fassito/drone-2026/.github/skills/oled-display/references/ssd1306-vs-sh1106.md

# Referencia rápida: OLED SSD1306 vs SH1106

## Identificación

| Controlador | Tamaño | Resolución | Dirección I2C | Librería |
|---|---|---|---|---|
| **SSD1306** | 0.96" | 128×64 | `0x3C` (común) | Adafruit SSD1306 |
| **SH1106** | 1.3" | 128×64 | `0x3C` o `0x3D` | Adafruit SH110X / U8g2 |

Ambos usan 4 pines: **GND, VCC, SCL, SDA**.

## Cableado (ESP32)

| OLED | ESP32 |
|---|---|
| GND | GND |
| VCC | 3.3 V (o 5 V según módulo) |
| SCL | GPIO 22 |
| SDA | GPIO 21 |

## Escáner I2C (si no se conoce la dirección)

```cpp
#include <Wire.h>
void setup() {
  Wire.begin();
  Serial.begin(115200);
  for (uint8_t a = 1; a < 127; a++) {
    Wire.beginTransmission(a);
    if (Wire.endTransmission() == 0) {
      Serial.printf("I2C device en 0x%02X\n", a);
    }
  }
}
void loop() {}
```

## Librerías (platformio.ini)

- SSD1306:
  ```ini
  lib_deps =
      adafruit/Adafruit GFX Library @ ^1.11.9
      adafruit/Adafruit SSD1306 @ ^2.5.7
  ```
- SH1106 (con U8g2, soporta ambos chips):
  ```ini
  lib_deps =
      olikraus/U8g2 @ ^2.34.22
  ```

## Vistas propuestas

| Vista | Contenido |
|---|---|
| `status` | Armado, modo de vuelo, fallos |
| `attitude` | Roll, pitch, yaw |
| `gps` | Fix, satélites, lat/lon |
| `obstacle` | Distancias de los 4 Sharp |

## Notas

- Refrescar a 5–10 Hz desde una tarea RTOS separada (I2C es lento y bloqueante).
- La pantalla no debe ralentizar el bucle de control de 1 kHz.
