fassito/drone-2026/pcb/BOM.csv

Referencia | Componente | Pines | Nota
BEC1 | BEC 5V | 4
D1 | Flyback 1N4148 | 2
D2 | LED estado | 2
ESC1 | ESC 1 | 3
ESC2 | ESC 2 | 3
ESC3 | ESC 3 | 3
ESC4 | ESC 4 | 3
J1 | ESP32 DevKit V1 | 25
J2 | FS-IA6B iBus | 3
LS1 | Buzzer 5V | 2
Q1 | NPN 2N2222 | 3
R1 | Divisor 2.2k | 2
R2 | Divisor 4.7k | 2
R3 | Base 1k | 2
U10 | Sharp B | 3
U11 | Sharp L | 3
U2 | BMP388 CJMCU-388 | 6
U3 | INA219 | 6
U4 | OLED SSD1306 | 4
U5 | MPU-9250 GY-951 | 6
U6 | GPS Neo 6M | 4
U7 | HC-12 | 5
U8 | Sharp FR | 3
U9 | Sharp R | 3
XT1 | XT-60 batería | 2
