fassito/drone-2026/pcb/drone-2026.kicad_pcb

## KiCad design pcb/drone-2026.kicad_pcb (2026-11-11)

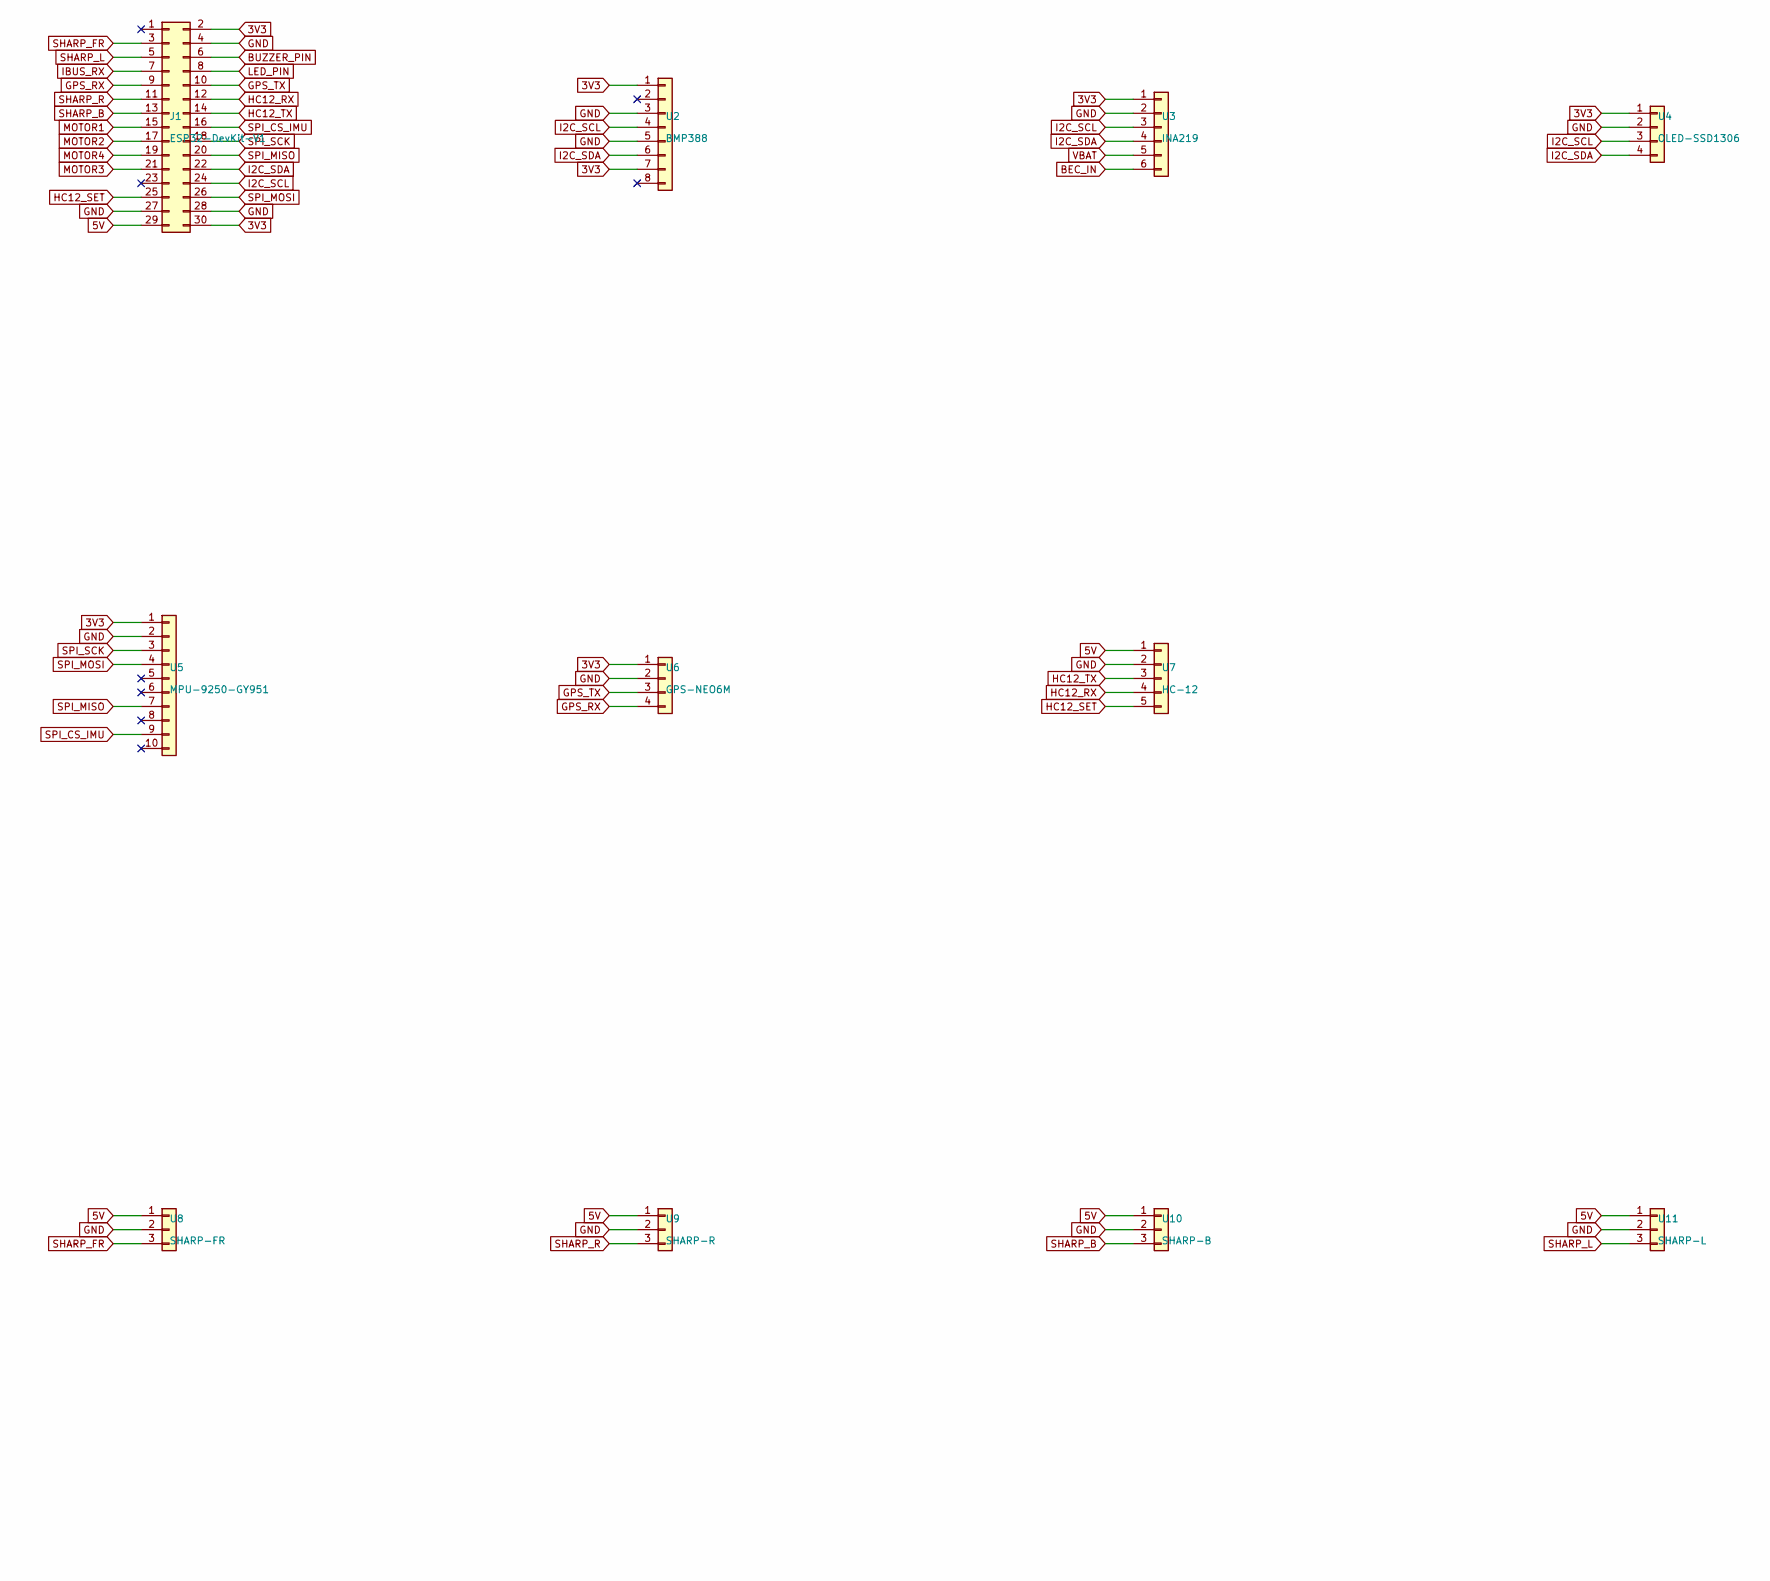
[picture p1: schematic drone-2026.kicad_sch, part in row 1, column 1]

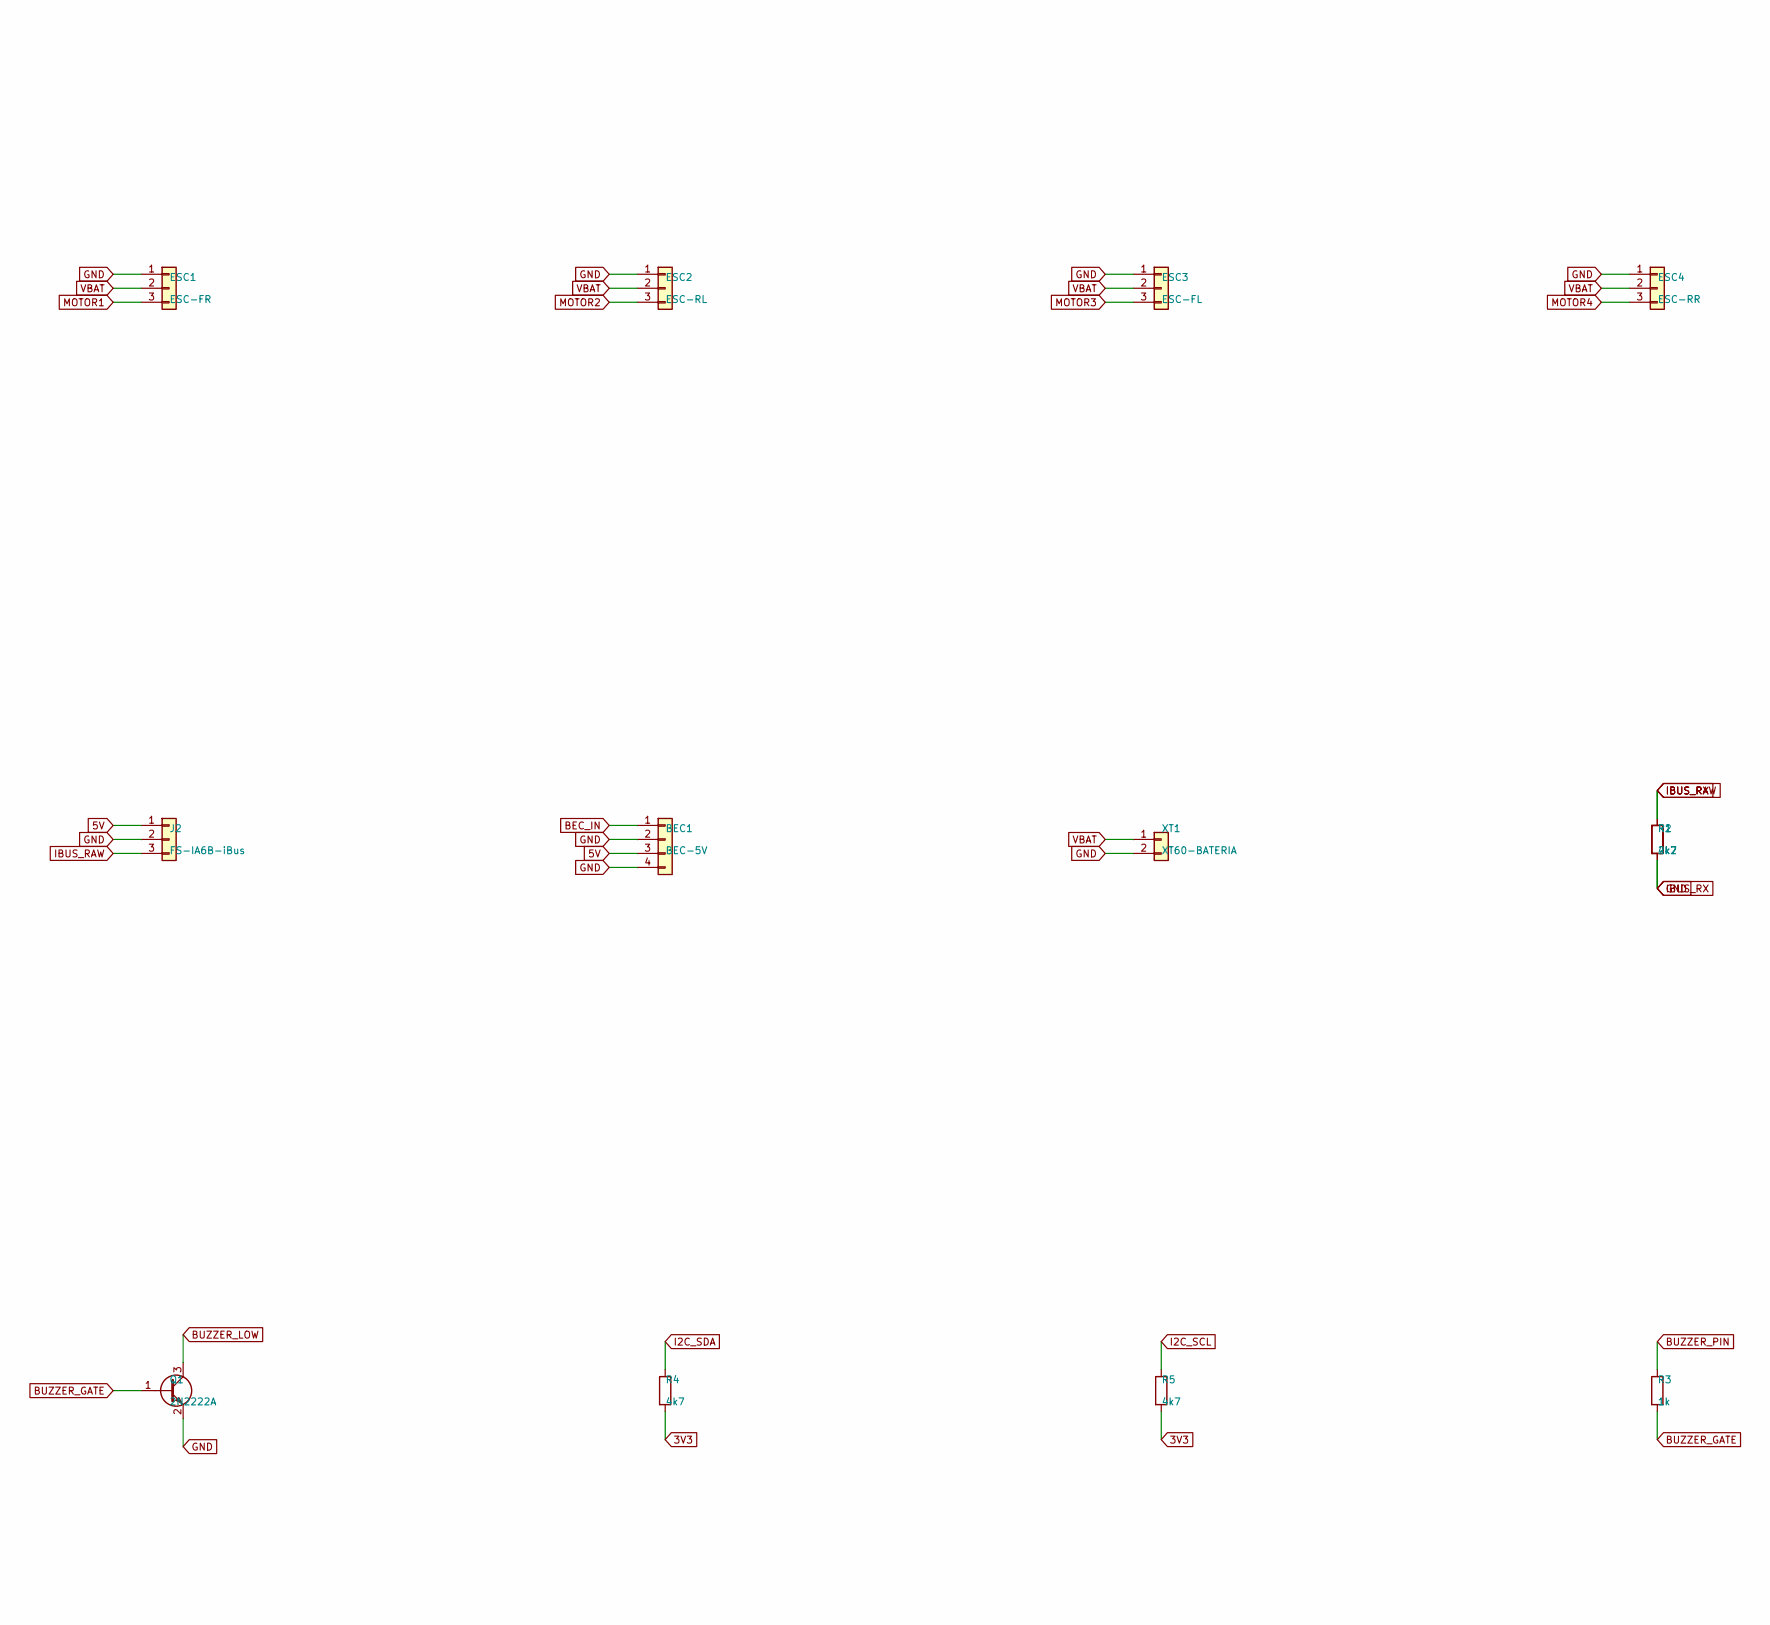
[picture p2: schematic drone-2026.kicad_sch, part in row 2, column 1]

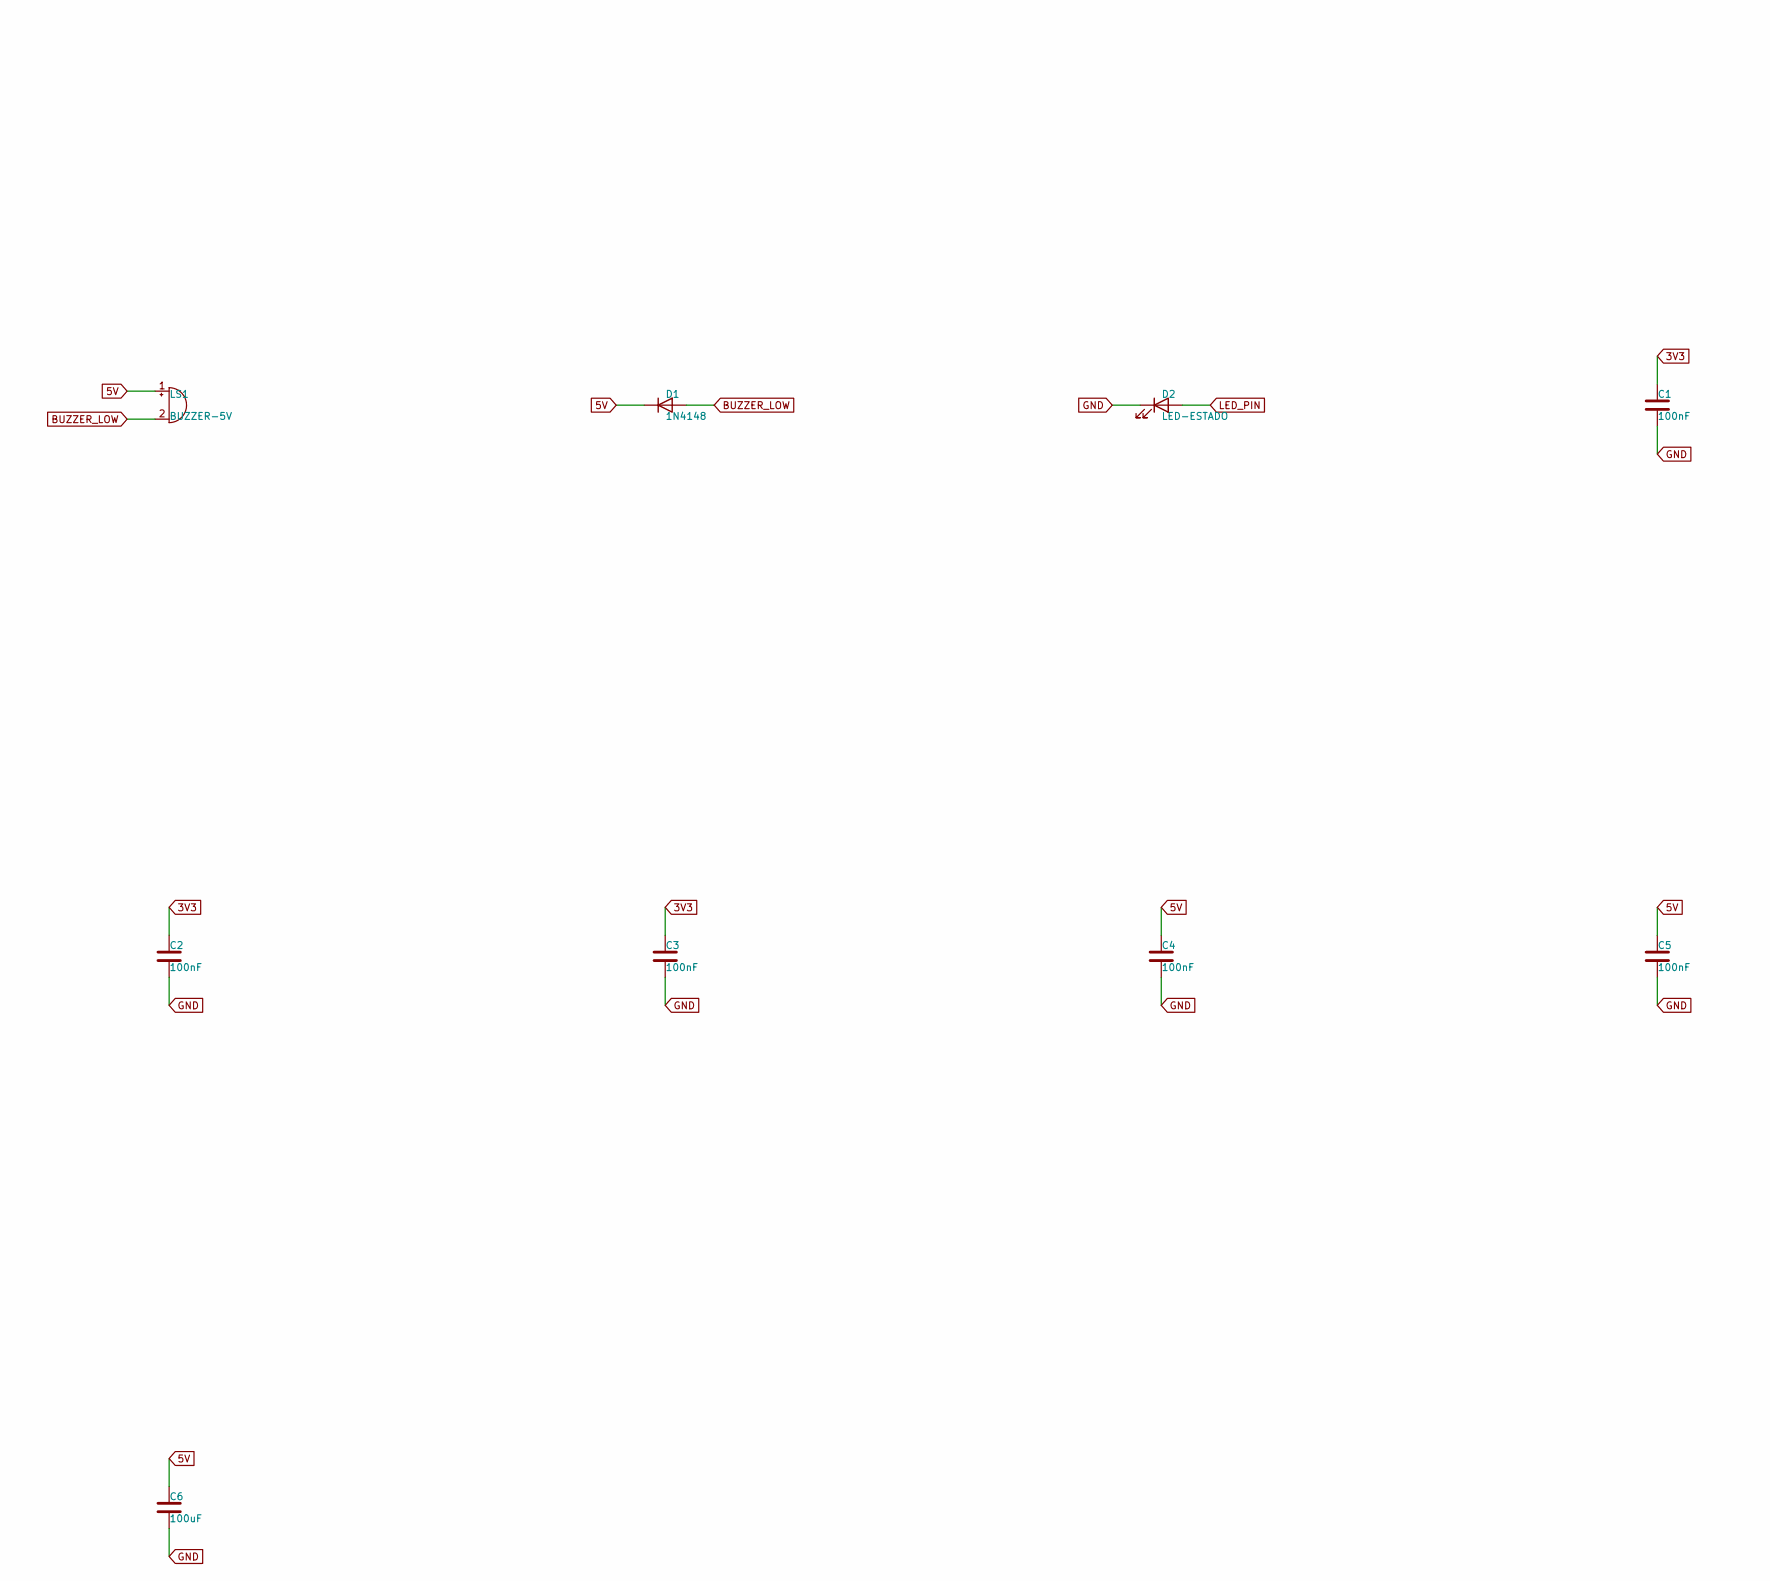
[picture p3: schematic drone-2026.kicad_sch, part in row 3, column 1]

Parts:
BEC1: BEC-5V; PinHeader_1x04_P2.54mm_Vertical
C1, C2, C3, C4, C5: 100nF; C_Disc_D5.0mm_W2.5mm_P2.50mm
C6: 100uF; C_Disc_D5.0mm_W2.5mm_P2.50mm
D1: 1N4148; D_DO-35_SOD27_P7.62mm_Horizontal
D2: LED-ESTADO; LED_D5.0mm
ESC1: ESC-FR; PinHeader_1x03_P2.54mm_Vertical
ESC2: ESC-RL; PinHeader_1x03_P2.54mm_Vertical
ESC3: ESC-FL; PinHeader_1x03_P2.54mm_Vertical
ESC4: ESC-RR; PinHeader_1x03_P2.54mm_Vertical
J1: ESP32-DevKit-V1; PinSocket_2x15_P2.54mm_Vertical
J2: FS-IA6B-iBus; PinHeader_1x03_P2.54mm_Vertical
LS1: BUZZER-5V; Buzzer_12x9.5RM7.6
Q1: 2N2222A; TO-92_Inline
R1: 2k2; R_Axial_DIN0207_L6.3mm_D2.5mm_P7.62mm_Horizontal
R2, R4, R5: 4k7; R_Axial_DIN0207_L6.3mm_D2.5mm_P7.62mm_Horizontal
R3: 1k; R_Axial_DIN0207_L6.3mm_D2.5mm_P7.62mm_Horizontal
U2: BMP388; PinHeader_1x08_P2.54mm_Vertical
U3: INA219; PinHeader_1x06_P2.54mm_Vertical
U4: OLED-SSD1306; PinHeader_1x04_P2.54mm_Vertical
U5: MPU-9250-GY951; PinHeader_1x10_P2.54mm_Vertical
U6: GPS-NEO6M; PinHeader_1x04_P2.54mm_Vertical
U7: HC-12; PinHeader_1x05_P2.54mm_Vertical
U8: SHARP-FR; PinHeader_1x03_P2.54mm_Vertical
U9: SHARP-R; PinHeader_1x03_P2.54mm_Vertical
U10: SHARP-B; PinHeader_1x03_P2.54mm_Vertical
U11: SHARP-L; PinHeader_1x03_P2.54mm_Vertical
XT1: XT60-BATERIA; PinHeader_1x02_P2.54mm_Vertical

Connections:
3V3: C1.1, C2.1, C3.1, J1.2, J1.30, R4.2, R5.2, U2.1, U2.7, U3.1, U4.1, U5.1, U6.1
5V: BEC1.3, C4.1, C5.1, C6.1, D1.1 (K), J1.29, J2.1, LS1.1 (+), U7.1, U8.1, U9.1, U10.1, U11.1
BEC_IN: BEC1.1, U3.6
BUZZER_GATE: Q1.1 (B), R3.2
BUZZER_LOW: D1.2 (A), LS1.2 (-), Q1.3 (C)
BUZZER_PIN: J1.6, R3.1
GPS_RX: J1.9, U6.4
GPS_TX: J1.10, U6.3
HC12_RX: J1.12, U7.4
HC12_SET: J1.25, U7.5
HC12_TX: J1.14, U7.3
I2C_SCL: J1.24, R5.1, U2.4, U3.3, U4.3
I2C_SDA: J1.22, R4.1, U2.6, U3.4, U4.4
LED_PIN: D2.2 (A), J1.8
MOTOR1: ESC1.3, J1.15
MOTOR2: ESC2.3, J1.17
MOTOR3: ESC3.3, J1.21
MOTOR4: ESC4.3, J1.19
SHARP_B: J1.13, U10.3
SHARP_FR: J1.3, U8.3
SHARP_L: J1.5, U11.3
SHARP_R: J1.11, U9.3
SPI_CS_IMU: J1.16, U5.9
SPI_MISO: J1.20, U5.7
SPI_MOSI: J1.26, U5.4
SPI_SCK: J1.18, U5.3
VBAT: ESC1.2, ESC2.2, ESC3.2, ESC4.2, U3.5, XT1.1

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
Board: 2 copper layers, 37 parts (0 on the bottom side), 30 nets, no tracks yet.

Other parts of the board:
H1, H2, H3, H4: MountingHole_3.2mm_M3
