fassito/drone-2026/firmware/src/telemetry/ota.h

#pragma once

// ============================================================
// OTA (actualización de firmware por WiFi, solo en tierra).
// ============================================================

void ota_init(void);
void ota_handle(void);
