fassito/drone-2026/(commit log)

2026-11-09 Initial commit: drone-2026 firmware, skills and agents
    ESP32 DevKit V1 quadcopter firmware (Arduino/PlatformIO):
    - Flight control (cascaded PID @1kHz, quad-X mixer, auto-tune)
    - Sensors (MPU-9250 SPI + AK8963 mag, Madgwick 9DoF, BMP388)
    - Navigation (GPS NMEA, waypoints, autopilot, geofence, RTH, altitude)
    - Radio/telemetry (iBus, HC-12, WiFi CLI, OLED, OTA, blackbox)
    - Safety (failsafe, power monitor, indicators, selftest)
    - Host test battery (136 checks) + hardware bring-up docs
    [altitude_control.cpp, altitude_control.h, autopilot.cpp, autopilot.h, autotune.cpp, autotune.h, blackbox.cpp, blackbox.h]
2026-11-09 Fix IMU/mag bring-up: AK8963 aux-master read, yaw ANGLE bug, live attitude display
    - mpu9250: read AK8963 via SLV0 (canonical SparkFun), detect by WIA=0x48
    instead of DRDY (master clears it continuously); fix 7-byte read length;
    add mag_present/mag_wia/mag_cntl1 getters for boot diagnostics.
    - flight_control: fix yaw in ANGLE mode (rate setpoint vs angle feedback
    mismatch); heading-hold only in NAV mode.
    - main: enable I2C internal pull-ups for bare 4-pin OLED modules; add
    R/P/Y (deg) to 1 Hz heartbeat and step markers in I2C init.
    - cli: richer attitude command (gyro + mag status); new oled view command.
    - oled: default view = attitude (R/P/Y + gyro_z + mag status).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
    [cli.cpp, flight_control.cpp, main.cpp, mpu9250.cpp, mpu9250.h, oled_display.cpp]
2026-11-11 Add BMP388 barometer bring-up: init retry, boot diagnostic, OLED baro view
    - bmp388: retry begin_I2C (CJMCU-388 times out on first contact after
    power-up); oversampling/filter/ODR config.
    - main: settled [baro] boot diagnostic (discard first readings).
    - oled: new BARO view (temp/pressure/altitude) as default for bring-up.
    - cli: add 'oled baro' view switch.
    - docs: CJMCU-388 pin mapping for I2C mode (CS high, SDO->GND=0x76).
2026-11-11 Add PCB integration board: KiCad project, validated netlist, BOM and design spec
    Carrier board that consolidates the drone wiring (ESP32 DevKit V1 plug-in):
    - netlist.csv: 104 connections, 30 nets (from config.h + conexiones.md)
    - BOM.csv: 25 references
    - DESIGN.md: power topology, layout rules, fabrication notes
    - Key design decision: ESCs feed straight from VBAT; INA219 measures only
    battery voltage + BEC branch current (its 0.1ohm shunt maxes at ~3.2A and
    cannot handle motor current). Motor overcurrent covered by voltage-sag +
    tilt-limit failsafes (no new components).
    [BOM.csv, netlist.csv]
2026-11-11 Add empty KiCad schematic and board files (open in project manager)
    Creates drone-2026.kicad_sch (valid, 0 ERC) and drone-2026.kicad_pcb
    (valid; DRC only flags missing Edge.Cuts outline, expected until layout).
    [drone-2026.kicad_pcb, drone-2026.kicad_sch]
2026-11-11 Generate full KiCad schematic by script (ERC clean, 33 components)
    KiCad 10 flatpak could not resolve the symbol library table even with
    KICAD10_SYMBOL_DIR set, so the schematic is generated programmatically
    with embedded symbol definitions instead of using the GUI chooser.
    - generate_schematic.py: parses library symbols, embeds them into
    lib_symbols, places each component and connects every pin through a
    wire stub + global label so the netlist matches netlist.csv.
    - Netlist validated: GND 36 pins, 3V3/5V 13 each, VBAT 6, I2C 5 each,
    BEC_IN 2; no single-pin nets. ERC: 0 violations.
    - Fixed during validation: Y-axis convention (iy - py), vertical pin
    outward direction (90/270 were sw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
    [drone-2026.kicad_pcb, drone-2026.kicad_sch]
2026-11-11 Reassign pins so all 4 Sharp sensors use ADC1 on the 30-pin DevKit
    GPIO37/38 are not exposed on the ESP32 DevKit V1 30-pin header, so the
    right and back Sharp connectors had no signal. Free IO32/IO33 (both ADC1)
    for them and move the two motor outputs off those pins.
    Sharp FR IO36 (VP) Sharp R IO37 -> IO32
    Sharp B IO38 -> IO33 Sharp L IO39 (VN)
    MOTOR3 IO32 -> IO14 MOTOR4 IO33 -> IO27
    BUZZER IO27 -> IO15
    GPIO12 was rejected for a motor output: it is MTDI, a strapping pin that
    selects 1.8 V flash if high at boot (would prevent booting). GPIO15 is
    used only for the buzzer, where its boot-high default is harmless (the
    1k base resistor of the NPN does not pull it down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
    [drone-2026.kicad_sch, netlist.csv]
2026-11-11 Place the PCB: 75x75 mm, 33 footprints, nets assigned, DRC clean
    Adds pcb_layout.py, which drives the KiCad pcbnew API to build the board
    from the same component table used for the schematic:
    - Board outline 75x75 mm on Edge.Cuts and four M3 holes on the standard
    30.5x30.5 mm pattern. The side is chosen automatically as the smallest
    square where every footprint fits without invading a hole.
    - Shelf packing with the holes as obstacles; the footprint bounding-box
    offset is honoured so boxes land exactly where computed (a previous
    attempt overlapped because the bbox is not centred on the origin).
    - Nets created and assigned to every pad; value text hidden to keep the
    silkscreen clean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
    [drone-2026.kicad_pcb, drone-2026.kicad_sch]
2026-11-11 Add GND plane on B.Cu and fix net assignment for name-based pins
    - pcb_layout.py: nets were looked up only by pad number, so Q1 (B/C/E),
    D1 and D2 (K/A) ended up with no net at all. The mapping now falls back
    to the symbol pin name, resolved to a pad number via the library symbol.
    - pcb_layout.py: load_symbol falls back to the sandbox path when running
    under flatpak (the host runtime path is not visible there).
    - add_gnd_zone.py: new script that creates and fills a GND zone on B.Cu
    with thermal reliefs. Re-runnable after routing to refill.
    - Board regenerated: 75x75 mm, 33 footprints, GND plane, DRC 0 violations
    (63 unrouted items remaining).
    - DESIGN.md: layout status and a routin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
    [drone-2026.kicad_pcb]
2026-11-11 Enlarge the board to 90x90 mm for hand routing
    With 3.5 mm between footprints the board grows to 90x90 mm, which leaves
    wide corridors for manual routing. Placement, mounting holes and the GND
    plane are unchanged and DRC stays at 0 violations with 63 unrouted items.
    An A* autorouter (2 layers, vias, exact geometric validation, per-net
    rollback) was implemented and evaluated at 75, 90 and 160 mm. It only ever
    routed 1-6 of the 29 nets before deadlocking: when several adjacent pads of
    a connector need to escape, the first track occupies the corridor the next
    one needs, and without rip-up-and-retry there is no way out. The code was
    removed rather than left in the tree as broken tooling; DESIGN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
    [drone-2026.kicad_pcb]
2026-11-11 Strip the board to components and nets; add a guided routing document
    Per the request to leave only what has to be connected, the delivered
    board now contains the 33 footprints with their nets, the 90x90 mm
    outline and the four M3 holes. No tracks, vias or zones.
    - generate_routing_guide.py: reads the board and writes GUIA_ENRUTADO.md
    listing every net in routing order with its pads, their coordinates in
    mm, the recommended track width and a note per block. Multi-pad nets are
    chained by nearest neighbour so the suggested path flows.
    - DESIGN.md: documents that routing is manual and why the A* autorouter
    was dropped.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
    [drone-2026.kicad_pcb]
2026-11-11 Set battery thresholds for the 4S 1550 mAh pack
    The failsafe thresholds were still 3S values (10.5 V / 10.0 V), which a 4S
    pack never reaches: the low-battery failsafe would simply never fire.
    - BATTERY_LOW_V 10.5 -> 14.0 (3.50 V/cell -> land)
    - BATTERY_CRITICAL_V 10.0 -> 13.2 (3.30 V/cell -> cut motors)
    - BATTERY_CELLS 3 -> 4
    - MAX_CURRENT_A 20.0 -> 2.0 the INA219 only sees the BEC branch
    (its 0.1 ohm shunt handles ~3.2 A), so 20 A could never trigger; 2 A
    now detects a short in the electronics. Stuck-motor protection relies on
    the voltage-sag and tilt-limit failsafes.
    Docs updated for the 4S 1550 mAh pack. Firmware builds, 136/136 host tests
    pass.
    Co-authored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
    [config.h]
2026-11-11 Stop tracking KiCad local history directory
2026-11-11 Stop tracking KiCad project-local settings file
2026-11-11 Add ENABLE_INA219 flag and expose power state at boot
    The INA219 is wired to I2C but not detected yet (no 0x40 on the bus).
    While it is absent, the firmware treated the reading as valid-but-zero
    volts and the battery failsafe would block arming. The new ENABLE_INA219
    flag (default 0, like the other peripherals) keeps the power monitor out
    of the failsafe until the module is detected and Vin+/Vin- are wired.
    Also prints "[ina] ok=... v=... i=..." at boot so bring-up of the module
    is visible on the serial console.
    [config.h, main.cpp]
2026-11-11 Enable the INA219 now that it is detected on the bus
    The module was miswired; after fixing it the scan shows 0x3C, 0x40 and
    0x76 and the chip reads back correctly ([ina] ok=1).
    - ENABLE_INA219 -> 1.
    - BATTERY_MIN_PLAUSIBLE_V (6.0 V): the failsafe now ignores voltage
    readings below any real 4S pack. Without Vin+/Vin- wired the INA219
    reads ~0.9 V, which would otherwise be taken as a flat battery and
    block arming. A missing sensor now means "no voltage protection"
    instead of a false "battery critical".
    Firmware builds, 136/136 host tests pass.
    [config.h, main.cpp]
2026-11-11 Add battery energy management from pack voltage
    The INA219 cannot see motor current (its shunt handles ~3.2 A and the ESCs
    bypass it), so energy management is derived from the pack voltage, which
    is the metric that actually reflects a LiPo's state of charge.
    - safety/battery: pure module with the LiPo discharge curve. Provides
    cell voltage, state of charge, remaining mAh for a given pack capacity,
    and a level (OK / LOW -> land / CRITICAL -> cut).
    - main: failsafe now uses CRITICAL for the motor cut and LOW for the
    advisory beep, instead of the previous inline threshold check. Invalid
    readings (below BATTERY_MIN_PLAUSIBLE_V) never trigger the failsafe.
    - CLI "power" now reports cell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
    [battery.cpp, battery.h, cli.cpp, config.h, main.cpp, oled_display.cpp, telemetry_data.h, test_battery.c]
